nipil/arduino_spindle_encoder/perfboard-connection-card.odt

W : 5V DC U : GND S+Q : button O: enc GND M: enc 5V K: enc Z I: enc B G: enc A E: enc shield | J2: SHD-to-GND J1/08: ICP RST J1/07: ICP RX J1/06: ICP TX J1/05: ICP 5V J1/04: ICP GND H1/col_u: DBG H1/other: GND
