nipil/arduino_spindle_encoder/BOM.csv

ID | Name | Designator | Footprint | Quantity | Manufacturer Part | Manufacturer | Supplier | Supplier Part | Price
1 | KF301-5.0-2P | BTN,PWR | CONN-TH_P5.00_KF301-5.0-2P | 2 | KF301-5.0-2P | KEFA(科发) | LCSC | C474881 | 0.086
2 | 1u | C2 | CAP-D6.3×F2.5 | 1
3 | KF301-5.0-3P | ENCL,ENCR | CONN-TH_3P-P5.00_KF301-5.0-3P | 2 | KF301-5.0-3P | KEFA(科发) | LCSC | C474882 | 0.122
4 | HDR-F-2.54_1x2 | H1 | HDR-F-2.54_1X2 | 1 |  |  | LCSC | C49661 | 0.038
5 | HDR-M-2.54_1x5 | J1 | HDR-M-2.54_1X5 | 1 |  |  | LCSC | C358687 | 0.03
6 | HDR-M-2.54_1x2 | J2 | HDR-M-2.54_1X2 | 1 |  |  | LCSC | C124375 | 0.025
7 | 5641AS | LEDS | 5641AS | 1
8 | 330 | R1,R2,R3,R4 | R_AXIAL-0.5 | 4
9 | 3.3k | R5,R6,R7 | R_AXIAL-0.5 | 3
10 | 10k | R8,R9 | R_AXIAL-0.5 | 2
11 | ATMEGA328P-PU | U10 | DIP-28_L34.6-W7.3-P2.54-LS10.2-BL | 1 | ATMEGA328P-PU | MICROCHIP(美国微芯) | LCSC | C33901 | 2.203
