nipil/arduino_spindle_encoder/arduino_spindle_encoder.ino

/************************* optional stuff *************************/

// Using an encoder with a Z pin allows for a "fixed" homing
// This allows your position to be found again after a power loss
// #define USE_Z_RESET

// Use a digital pin to allow scoping interrupt duration
// #define USE_ISR_WAVEFORM

// Serial compile-time flag (use macros below)
// #define USE_SERIAL_PRINT

// Allow raw counter display
// #define USE_RAW_DISPLAY

// Display clock cycles of sensitive functions (requires USE_SERIAL_PRINT !)
// #define USE_TIMING

/************************** Configuration ******************************/

// For pins, you can use "native Arduino" pin numbers, or PIN_Pxy port defines from arduino.h,
// The latter allows clearer mapping, when using bare chipsets, like on the perfboards

// Display configuration (Arduino PINS)
#define CONFIG_PIN_OUT_SEGMENT_A 9
#define CONFIG_PIN_OUT_SEGMENT_B 13
#define CONFIG_PIN_OUT_SEGMENT_C 5
#define CONFIG_PIN_OUT_SEGMENT_D 7
#define CONFIG_PIN_OUT_SEGMENT_E 8
#define CONFIG_PIN_OUT_SEGMENT_F 10
#define CONFIG_PIN_OUT_SEGMENT_G A0
#define CONFIG_PIN_OUT_SEGMENT_DP 6
#define CONFIG_PIN_OUT_DIGIT_1 A2
#define CONFIG_PIN_OUT_DIGIT_2 A3
#define CONFIG_PIN_OUT_DIGIT_3 A4
#define CONFIG_PIN_OUT_DIGIT_4 A5
#define CONFIG_SEGMENT_ON_TIME_MICROS 10

// Encoder configuration (Arduino PINS)
#define CONFIG_ENCODER_PULSES_PER_REVOLUTION 1024  // number of rising edges per revolution !! PER signal !!
#define CONFIG_ENCODER_COUNTER_TYPE uint32_t       // choose uint16_t if your change rate is slow enough so you do not have overflows...
#define CONFIG_PIN_IN_QUAD_A 2
#define CONFIG_PIN_IN_QUAD_B 3
#if defined(USE_Z_RESET)
#define CONFIG_PIN_IN_QUAD_Z 4
#define CONFIG_PIN_IN_QUAD_Z_ACTIVE_STATE HIGH
#endif  // USE_Z_RESET

// UI configuration (Arduino PINS)
#define CONFIG_PIN_IN_BUTTON 12
#define CONFIG_PIN_IN_BUTTON_ACTIVE_STATE LOW
#define CONFIG_BUTTON_DEBOUNCE_MILLIS 100
#define CONFIG_BUTTON_LONG_PRESS_MILLIS 1000
#define CONFIG_UI_INTERVAL_MILLIS 500
#define CONFIG_DISPLAY_MODE_TEST_DURATION_MILLIS 1000

// Use led pin to scope for interrupt duration (Arduino PINS)
#if defined(USE_ISR_WAVEFORM)
#define CONFIG_PIN_OUT_ISR_WAVEFORM 11
#endif  // USE_ISR_WAVEFORM

// Define different macros for configurable digital pin manipulations
#define THROW_ERROR_IF_NOT_FAST  // MUST be declared before the include
#include <digitalWriteFast.h>

/************************* Macros *************************/

#if defined(USE_SERIAL_PRINT)
#define SERIAL_BEGIN(X) \
  do { Serial.begin(X); } while (0)
#define SERIAL_PRINT(X) \
  do { Serial.print(X); } while (0)
#define SERIAL_PRINTLN(X) \
  do { Serial.println(X); } while (0)
#define SERIAL_PRINT_2(X, Y) \
  do { Serial.print(X, Y); } while (0)
#define SERIAL_PRINTLN_2(X, Y) \
  do { Serial.println(X, Y); } while (0)
#else
#define SERIAL_BEGIN(X)
#define SERIAL_PRINT(X)
#define SERIAL_PRINTLN(X)
#define SERIAL_PRINT_2(X, Y)
#define SERIAL_PRINTLN_2(X, Y)
#endif

// Timer1 can be used to time things while running on target chip, but offline disassembly can too :
//    open disassembly file in the build folder C:\Users\xxxx\AppData\Local\arduino\sketches\YYYY\*.lst
//    look the address range you want to analyse
//    disassemble it again using avrdude,including the clock cycle count :
//      avrdude -p m8a  -c dryrun -U sketch.elf -T 'disasm -q flash 0x116 0x80'
//    and sum up the numbers in the second column !

#define PRINT_CLOCK_CYCLES(LABEL, X) \
  do { \
    TCCR1A = 0; \
    TCCR1B = 0; \
    TCNT1 = 0; \
    bitClear(TIFR, TOV1); \
    TCCR1B = 1; \
    X; \
    TCCR1B = 0; \
    bitClear(TIFR, TOV1); \
    SERIAL_PRINT(LABEL); \
    SERIAL_PRINT("="); \
    SERIAL_PRINT(TCNT1 - 1); \
    SERIAL_PRINT(" ovf="); \
    SERIAL_PRINTLN(bitRead(TIFR, TOV1)); \
  } while (0)

/************************** Library ******************************/

class Error {
public:
  typedef enum {
    ERROR_CODE_NONE = 0,
    ERROR_CODE_QUADRATURE,
  } Code;

  Error(const Code code, const uint32_t value = 0)
    : code(code), value(value) {}

  const Code code;
  const uint32_t value;
};

class Glyph {
public:
  typedef enum {
    // bit order is 0bPGFEDCBA
    DIGIT_ZERO = 0b00111111,
    DIGIT_ONE = 0b00000110,
    DIGIT_TWO = 0b01011011,
    DIGIT_THREE = 0b01001111,
    DIGIT_FOUR = 0b01100110,
    DIGIT_FIVE = 0b01101101,
    DIGIT_SIX = 0b01111101,
    DIGIT_SEVEN = 0b00000111,
    DIGIT_EIGHT = 0b01111111,
    DIGIT_NINE = 0b01101111,
    LETTER_I_LOWERCASE = 0b00010000,
    LETTER_N_LOWERCASE = 0b01010100,
    LETTER_T_LOWERCASE = 0b01111000,
    LETTER_E_UPPERCASE = 0b01111001,
    SYMBOL_SPACE = 0b00000000,
    SYMBOL_PERIOD = 0b10000000,
  } Bits;

  Glyph(const uint8_t bits)
    : bits(bits) {}

  void or_with(const Glyph& other) {
    bits |= other.bits;
  }

  uint8_t bits;
};

class GlyphLibrary {
public:
  typedef enum {
    DIGIT_ZERO = 0,
    DIGIT_ONE,
    DIGIT_TWO,
    DIGIT_THREE,
    DIGIT_FOUR,
    DIGIT_FIVE,
    DIGIT_SIX,
    DIGIT_SEVEN,
    DIGIT_EIGHT,
    DIGIT_NINE,
    LETTER_I_LOWERCASE,
    LETTER_N_LOWERCASE,
    LETTER_T_LOWERCASE,
    LETTER_E_UPPERCASE,
    SYMBOL_SPACE,
    SYMBOL_PERIOD,
    INDEX_MAX
  } GlyphIndex;

  static const Glyph GLYPHS[];

  static const Glyph& get_glyph(const uint8_t index) {
    if (index >= INDEX_MAX) {
      return GLYPHS[SYMBOL_SPACE];
    }
    return GLYPHS[index];
  }
};

const Glyph GlyphLibrary::GLYPHS[INDEX_MAX] = {
  Glyph(Glyph::Bits::DIGIT_ZERO),
  Glyph(Glyph::Bits::DIGIT_ONE),
  Glyph(Glyph::Bits::DIGIT_TWO),
  Glyph(Glyph::Bits::DIGIT_THREE),
  Glyph(Glyph::Bits::DIGIT_FOUR),
  Glyph(Glyph::Bits::DIGIT_FIVE),
  Glyph(Glyph::Bits::DIGIT_SIX),
  Glyph(Glyph::Bits::DIGIT_SEVEN),
  Glyph(Glyph::Bits::DIGIT_EIGHT),
  Glyph(Glyph::Bits::DIGIT_NINE),
  Glyph(Glyph::Bits::LETTER_I_LOWERCASE),
  Glyph(Glyph::Bits::LETTER_N_LOWERCASE),
  Glyph(Glyph::Bits::LETTER_T_LOWERCASE),
  Glyph(Glyph::Bits::LETTER_E_UPPERCASE),
  Glyph(Glyph::Bits::SYMBOL_SPACE),
  Glyph(Glyph::Bits::SYMBOL_PERIOD),
};

typedef enum {
  COMMON_CATHODE = LOW,
  COMMON_ANODE = HIGH, /* TODO: untested */
} DisplayType;

class SevenSegmentPins {
public:
  typedef enum {
    SEGMENT_A = 0,
    SEGMENT_B,
    SEGMENT_C,
    SEGMENT_D,
    SEGMENT_E,
    SEGMENT_F,
    SEGMENT_G,
    SEGMENT_DP,
    SEGMENT_MAX
  } SegmentPinIndex;

  SevenSegmentPins(
    const DisplayType display_type,
    const uint16_t time_on_micros)
    : display_type(display_type),
      time_on_micros(time_on_micros) {}

  void setup() const {

#define LOCAL_MACRO_SETUP_SEGMENT_FAST(pin_number) \
  do { \
    pinModeFast(pin_number, OUTPUT); \
    digitalWriteFast(pin_number, display_type); \
  } while (0)

    LOCAL_MACRO_SETUP_SEGMENT_FAST(CONFIG_PIN_OUT_SEGMENT_A);
    LOCAL_MACRO_SETUP_SEGMENT_FAST(CONFIG_PIN_OUT_SEGMENT_B);
    LOCAL_MACRO_SETUP_SEGMENT_FAST(CONFIG_PIN_OUT_SEGMENT_C);
    LOCAL_MACRO_SETUP_SEGMENT_FAST(CONFIG_PIN_OUT_SEGMENT_D);
    LOCAL_MACRO_SETUP_SEGMENT_FAST(CONFIG_PIN_OUT_SEGMENT_E);
    LOCAL_MACRO_SETUP_SEGMENT_FAST(CONFIG_PIN_OUT_SEGMENT_F);
    LOCAL_MACRO_SETUP_SEGMENT_FAST(CONFIG_PIN_OUT_SEGMENT_G);
    LOCAL_MACRO_SETUP_SEGMENT_FAST(CONFIG_PIN_OUT_SEGMENT_DP);

#undef LOCAL_MACRO_SETUP_SEGMENT_FAST /* no further use */
  }

  void render_glyph(const Glyph& glyph) const {
    uint8_t glyph_bits = glyph.bits;
    bool segment_is_on;

#define LOCAL_MACRO_RENDER_SEGMENT_FAST(pin_number) \
  do { \
    segment_is_on = glyph_bits & 1; \
    digitalWriteFast(pin_number, !display_type ^ !segment_is_on); /* enable segment pin (if needed) */ \
    delayMicroseconds(time_on_micros); \
    digitalWriteFast(pin_number, display_type); /* disable segment pin (always) */ \
    glyph_bits >>= 1; \
  } while (0)

    LOCAL_MACRO_RENDER_SEGMENT_FAST(CONFIG_PIN_OUT_SEGMENT_A);
    LOCAL_MACRO_RENDER_SEGMENT_FAST(CONFIG_PIN_OUT_SEGMENT_B);
    LOCAL_MACRO_RENDER_SEGMENT_FAST(CONFIG_PIN_OUT_SEGMENT_C);
    LOCAL_MACRO_RENDER_SEGMENT_FAST(CONFIG_PIN_OUT_SEGMENT_D);
    LOCAL_MACRO_RENDER_SEGMENT_FAST(CONFIG_PIN_OUT_SEGMENT_E);
    LOCAL_MACRO_RENDER_SEGMENT_FAST(CONFIG_PIN_OUT_SEGMENT_F);
    LOCAL_MACRO_RENDER_SEGMENT_FAST(CONFIG_PIN_OUT_SEGMENT_G);
    LOCAL_MACRO_RENDER_SEGMENT_FAST(CONFIG_PIN_OUT_SEGMENT_DP);

#undef LOCAL_MACRO_RENDER_SEGMENT_FAST /* no further use */
  }

public:
  const DisplayType display_type;

private:
  const uint16_t time_on_micros;
};

typedef enum {
  DISPLAY_1 = 0,
  DISPLAY_2,
  DISPLAY_3,
  DISPLAY_4,
  DISPLAY_MAX
} DisplayIndex;

class Glyphs {
public:
  static const Glyphs INIT;
  static const Glyphs TEST;
  static const Glyphs EMPTY;

  Glyphs(const Glyph& glyph1, const Glyph& glyph2, const Glyph& glyph3, const Glyph& glyph4)
    : glyphs{ glyph1, glyph2, glyph3, glyph4 } {}

  Glyph& get_glyph(const DisplayIndex index) {
    if (index >= DISPLAY_MAX) {
      return glyphs[0];  // protection
    }
    return glyphs[index];
  }

  const Glyph& get_glyph_ref(const DisplayIndex index) const {
    // return get_glyph(index);  // does not compile due to const discard
    if (index >= DISPLAY_MAX) {
      return glyphs[0];  // protection
    }
    return glyphs[index];
  }

  static Glyphs build_uint16(uint16_t value, uint8_t min_digit) {
    GlyphLibrary::GlyphIndex digits[DISPLAY_MAX] = {
      GlyphLibrary::SYMBOL_SPACE,
      GlyphLibrary::SYMBOL_SPACE,
      GlyphLibrary::SYMBOL_SPACE,
      GlyphLibrary::SYMBOL_SPACE
    };
    for (uint8_t i = 0; i < DISPLAY_MAX; i++) {
      if (value == 0 && i >= min_digit) {
        break;
      }
      uint8_t units = value % 10;
      digits[i] = (GlyphLibrary::GlyphIndex)units;
      value = (value - units) / 10;
    }
    return Glyphs(  // rendering de gauche à droite
      GlyphLibrary::get_glyph(digits[3]),
      GlyphLibrary::get_glyph(digits[2]),
      GlyphLibrary::get_glyph(digits[1]),
      GlyphLibrary::get_glyph(digits[0]));
  }

private:
  static const Glyphs build_test() {
    Glyph full = GlyphLibrary::get_glyph(GlyphLibrary::DIGIT_EIGHT);
    full.or_with(GlyphLibrary::get_glyph(GlyphLibrary::SYMBOL_PERIOD));
    return Glyphs(full, full, full, full);
  }

  static const Glyphs build_init() {
    Glyph i = GlyphLibrary::get_glyph(GlyphLibrary::LETTER_I_LOWERCASE);
    return Glyphs(
      i,
      GlyphLibrary::get_glyph(GlyphLibrary::LETTER_N_LOWERCASE),
      i,
      GlyphLibrary::get_glyph(GlyphLibrary::LETTER_T_LOWERCASE));
  }

  static const Glyphs build_empty() {
    Glyph empty = GlyphLibrary::get_glyph(GlyphLibrary::SYMBOL_SPACE);
    return Glyphs(empty, empty, empty, empty);
  }

  Glyph glyphs[DISPLAY_MAX];
};

const Glyphs Glyphs::INIT = Glyphs::build_init();
const Glyphs Glyphs::TEST = Glyphs::build_test();
const Glyphs Glyphs::EMPTY = Glyphs::build_empty();

class FourDigitDisplay {
public:
  FourDigitDisplay(const SevenSegmentPins& segment_pins)
    : segment_pins(segment_pins) {}

  void setup() const {

#define LOCAL_MACRO_SETUP_DIGIT_FAST(pin_number) \
  do { \
    pinModeFast(pin_number, OUTPUT); \
    digitalWriteFast(pin_number, !segment_pins.display_type); \
  } while (0)

    LOCAL_MACRO_SETUP_DIGIT_FAST(CONFIG_PIN_OUT_DIGIT_1);
    LOCAL_MACRO_SETUP_DIGIT_FAST(CONFIG_PIN_OUT_DIGIT_2);
    LOCAL_MACRO_SETUP_DIGIT_FAST(CONFIG_PIN_OUT_DIGIT_3);
    LOCAL_MACRO_SETUP_DIGIT_FAST(CONFIG_PIN_OUT_DIGIT_4);

#undef LOCAL_MACRO_SETUP_DIGIT_FAST /* no further use */
  }

  void render_glyphs(const Glyphs& glyphs) const {

#define LOCAL_MACRO_RENDER_DIGIT_FAST(pin_number, display_number) \
  do { \
    digitalWriteFast(pin_number, segment_pins.display_type); /* enable digit pin */ \
    segment_pins.render_glyph(glyphs.get_glyph_ref(display_number)); \
    digitalWriteFast(pin_number, !segment_pins.display_type); /* disable digit pin */ \
  } while (0)

    LOCAL_MACRO_RENDER_DIGIT_FAST(CONFIG_PIN_OUT_DIGIT_1, DISPLAY_1);
    LOCAL_MACRO_RENDER_DIGIT_FAST(CONFIG_PIN_OUT_DIGIT_2, DISPLAY_2);
    LOCAL_MACRO_RENDER_DIGIT_FAST(CONFIG_PIN_OUT_DIGIT_3, DISPLAY_3);
    LOCAL_MACRO_RENDER_DIGIT_FAST(CONFIG_PIN_OUT_DIGIT_4, DISPLAY_4);

#undef LOCAL_MACRO_RENDER_DIGIT_FAST /* no further use */
  }

private:
  const SevenSegmentPins& segment_pins;
};


class Encoder {
public:
  typedef void (*IsrFunc)(void);

  Encoder(
    const uint16_t pulse_per_revolution
#if defined(USE_Z_RESET)
    ,
    const uint8_t pin_z_active_state
#endif  // USE_Z_RESET
    )
    : pulse_per_revolution(pulse_per_revolution),
      // Encoder count of A/B signal *changes* in a single turn
      // = max raw value before over/under flowing
      raw_value_range(pulse_per_revolution << 2)
#if defined(USE_Z_RESET)
      ,
      pin_z_active_state(pin_z_active_state)
#endif  // USE_Z_RESET
  {
  }

  void setup() const {
    pinModeFast(CONFIG_PIN_IN_QUAD_A, INPUT);
    pinModeFast(CONFIG_PIN_IN_QUAD_B, INPUT);
#if defined(USE_Z_RESET)
    pinModeFast(CONFIG_PIN_IN_QUAD_Z, INPUT);
#endif  // USE_Z_RESET
  }

  inline uint8_t get_pin_a() const __attribute__((always_inline)) {
    // 4 clock cycles
    return digitalReadFast(CONFIG_PIN_IN_QUAD_A);
  }

  inline uint8_t get_pin_b() const __attribute__((always_inline)) {
    // 4 clock cycles
    return digitalReadFast(CONFIG_PIN_IN_QUAD_B);
  }

#if defined(USE_Z_RESET)
  inline bool reset_detected() const __attribute__((always_inline)) {
    // 7 clock cycles
    return digitalReadFast(CONFIG_PIN_IN_QUAD_Z) == pin_z_active_state;
  }
#endif  // USE_Z_RESET

  void uninstall_all_isr() {
    detachInterrupt(digitalPinToInterrupt(CONFIG_PIN_IN_QUAD_A));
    detachInterrupt(digitalPinToInterrupt(CONFIG_PIN_IN_QUAD_B));
  }

  void install_isr_change_a_b(IsrFunc isr) {
    attachInterrupt(digitalPinToInterrupt(CONFIG_PIN_IN_QUAD_A), isr, CHANGE);
    attachInterrupt(digitalPinToInterrupt(CONFIG_PIN_IN_QUAD_B), isr, CHANGE);
  }

  void install_isr_rising_a(IsrFunc isr) {
    attachInterrupt(digitalPinToInterrupt(CONFIG_PIN_IN_QUAD_A), isr, RISING);
  }

public:
  const uint16_t pulse_per_revolution;
  const uint16_t raw_value_range;

private:
#if defined(USE_Z_RESET)
  const uint8_t pin_z_active_state;
#endif  // USE_Z_RESET
};

class Quadrature {
public:
  Quadrature(const Encoder& encoder)
    : encoder(encoder), state(0), counter(0), relative_zero(0), error_flag(0) {
#if defined(USE_Z_RESET)
    require_homing();
#endif  // USE_Z_RESET
  }

  inline void update_state_from_inputs() __attribute__((always_inline)) {
    // see time_sensitive_functions() for performance
    state = ((state & 0b0011) << 2) | ((encoder.get_pin_b() & 1) << 1) | (encoder.get_pin_a() & 1);
  }

  inline void update_counter_from_quadrature() __attribute__((always_inline)) {
    // see time_sensitive_functions() for performance
    const uint8_t result = LOOKUP[state];
    const int8_t delta = (int8_t)result & 0b00000111;
    counter += delta - 1;
    if (result > CW) {
      const uint8_t error = (result >> 3) & 0b00001111;
      error_flag |= error;
    }
#if defined(USE_Z_RESET)
    if (encoder.reset_detected()) {
      counter = 0;
      homing_canary = true;
    }
#endif  // USE_Z_RESET
  }

  void initialize_state() {
    // build a valid state from two reads
    update_state_from_inputs();
    update_state_from_inputs();
  }

  void setup() {
    initialize_state();
  }

  void clear_counter() {
    counter = 0;
  }

  inline void increment_counter() __attribute__((always_inline)) {
    // see time_sensitive_functions() for performance
    counter++;
  }

  uint32_t get_counter() const {
    return counter - relative_zero;
  }

  void set_relative_zero() {
    relative_zero = counter;
  }

  uint8_t get_error() const {
    return error_flag;
  }

  void clear_error() {
    initialize_state();
    error_flag = 0;
  }

#if defined(USE_Z_RESET)
  void require_homing() {
    homing_canary = false;
  }

  bool is_homed() const {
    return homing_canary;
  }
#endif  // USE_Z_RESET

  // 1 state bit for dual signal, and a before and after => 4 bits required
  static const uint8_t LOOKUP_SIZE = (1 << 4);

  // LookupResult has an integer values of "0bFEEEEVVV" where
  // - F is error flag
  // - E is error code (0-16)
  // - V is "counter_increment+1" on 3 bits
  typedef enum {
    CCW = 0,                 // -1 without error
    NOOP = 1,                // 0 without error
    CW = 2,                  // +1 without error
    INVALID_3 = 0b10011000,  // 0 with error and state was 0b0011 = 3
    INVALID_6 = 0b10110000,  // 0 with error and state was 0b0110 = 6
    INVALID_9 = 0b11001000,  // 0 with error and state was 0b1001 = 9
    INVALID_C = 0b11100000,  // 0 with error and state was 0b1100 = 12
  } LookupResult;

  static const uint8_t LOOKUP[];

private:
  const Encoder& encoder;
  volatile uint8_t state;
  volatile CONFIG_ENCODER_COUNTER_TYPE counter;
  CONFIG_ENCODER_COUNTER_TYPE relative_zero;
  volatile uint8_t error_flag;
#if defined(USE_Z_RESET)
  volatile bool homing_canary;
#endif  // USE_Z_RESET
};

const uint8_t Quadrature::LOOKUP[LOOKUP_SIZE] = {
  /* i old new        */
  /*    ba BA         */
  /* 0  00 00 same    */ NOOP,
  /* 1  00 01 cw 1    */ CW,
  /* 2  00 10 ccw 1   */ CCW,
  /* 3  00 11 invalid */ INVALID_3,
  /* 4  01 00 ccw 4   */ CCW,
  /* 5  01 01 same    */ NOOP,
  /* 6  01 10 invalid */ INVALID_6,
  /* 7  01 11 cw 2 Z  */ CW,
  /* 8  10 00 cw 4    */ CW,
  /* 9  10 01 invalid */ INVALID_9,
  /* A  10 10 same    */ NOOP,
  /* B  10 11 ccw 2   */ CCW,
  /* C  11 00 invalid */ INVALID_C,
  /* D  11 01 ccw 3 Z */ CCW,
  /* E  11 10 cw 3 Z  */ CW,
  /* F  11 11 same    */ NOOP
};

#if defined(USE_ISR_WAVEFORM)
class IsrMonitor {
public:
  void setup() const {
    pinModeFast(CONFIG_PIN_OUT_ISR_WAVEFORM, OUTPUT);
    digitalWriteFast(CONFIG_PIN_OUT_ISR_WAVEFORM, LOW);
  }

  inline void start() const __attribute__((always_inline)) {
    digitalWriteFast(CONFIG_PIN_OUT_ISR_WAVEFORM, HIGH);
  }

  inline void stop() const __attribute__((always_inline)) {
    digitalWriteFast(CONFIG_PIN_OUT_ISR_WAVEFORM, LOW);
  }
};
#endif  // USE_ISR_WAVEFORM

class DebouncedButton {
public:
  DebouncedButton(
    const uint8_t active_state,
    const uint32_t debounce_millis,
    const uint32_t long_press_millis)
    : active_state(active_state),
      debounce_millis(debounce_millis),
      long_press_millis(long_press_millis),
      last_value(0),
      stored_state(0),
      last_change_millis(0L),
      long_press_has_been_triggered(false) {}

  void setup() {
    pinModeFast(CONFIG_PIN_IN_BUTTON, INPUT);
    last_value = stored_state = digitalReadFast(CONFIG_PIN_IN_BUTTON);
    last_change_millis = millis();
  }

  bool update() {
    // read and debounce
    uint8_t current_state = digitalReadFast(CONFIG_PIN_IN_BUTTON);
    uint32_t current_millis = millis();
    if (current_state != stored_state) {
      stored_state = current_state;
      last_change_millis = current_millis;
    }
    if (stored_state != last_value && current_millis - last_change_millis > debounce_millis) {
      last_value = stored_state;  // change has persisted for long enough
      if (long_press_has_been_triggered && stored_state != active_state) {
        return false;  // after a long press, do NOT notify of button RELEASE
      }
      long_press_has_been_triggered = false;  // clear the long press event masking lag
      return true;                            // notify on value change
    }
    return false;
  }

  bool detect_long_press() {
    const uint32_t current_millis = millis();
    const uint32_t duration_millis = current_millis - last_change_millis;
    // 1) triggers on continuous press, so do not trigger while released
    // 2) do not trigger before a long press could have happened
    // 3) do not trigger if the long press already happened
    if (stored_state != active_state || duration_millis < long_press_millis || long_press_has_been_triggered) {
      return false;
    }
    // Mark it as happened so no more event
    long_press_has_been_triggered = true;
    return true;
  }

  bool is_active() const {
    return stored_state == active_state;
  }

private:
  const uint8_t active_state;
  const uint32_t debounce_millis;
  const uint32_t long_press_millis;
  uint8_t last_value;
  uint8_t stored_state;
  uint32_t last_change_millis;
  bool long_press_has_been_triggered;
};

/************************* Global variables (required for interrupts) *************************/

Encoder global_encoder(
  CONFIG_ENCODER_PULSES_PER_REVOLUTION
#if defined(USE_Z_RESET)
  ,
  CONFIG_PIN_IN_QUAD_Z_ACTIVE_STATE
#endif  // USE_Z_RESET
);

Quadrature global_quadrature(global_encoder);

/************************* Interrup service routines (need global variables) *************************/

#if defined(USE_ISR_WAVEFORM)
IsrMonitor global_isr_monitor;
#endif  // USE_ISR_WAVEFORM

void isr_position() {

#if defined(USE_ISR_WAVEFORM)
  global_isr_monitor.start();
#endif  // USE_ISR_WAVEFORM

  global_quadrature.update_state_from_inputs();
  global_quadrature.update_counter_from_quadrature();

#if defined(USE_ISR_WAVEFORM)
  global_isr_monitor.stop();
#endif  // USE_ISR_WAVEFORM
}

void isr_speed() {
#if defined(USE_ISR_WAVEFORM)
  global_isr_monitor.start();
#endif  // USE_ISR_WAVEFORM

  global_quadrature.increment_counter();

#if defined(USE_ISR_WAVEFORM)
  global_isr_monitor.stop();
#endif  // USE_ISR_WAVEFORM
}

/************************* Application code (needs ISR routines) *************************/

class RpmCalculator {
public:
  RpmCalculator(const Encoder& encoder, const Quadrature& quadrature)
    : encoder(encoder), quadrature(quadrature) {
    reset();
  }

  void reset() {
    last_rpm_computation_millis = millis();
    last_counter = quadrature.get_counter();
    rpm_value = 0;
  }

  void update() {
    uint32_t current_millis = millis();
    uint32_t interval_millis = current_millis - last_rpm_computation_millis;
    // only update every once in a while
    if (interval_millis > CONFIG_UI_INTERVAL_MILLIS) {
      last_rpm_computation_millis = current_millis;
      uint32_t current_counter = quadrature.get_counter();
      uint16_t counter_diff = current_counter - last_counter;
      last_counter = current_counter;
      // convert counter difference to "per minute" and switch to "millis"
      // divide by elasped time, keep only full turns, clip to display, and store
      uint32_t result = 60000 * counter_diff;
      result /= interval_millis * encoder.pulse_per_revolution;
      if (result > 9999) {
        result = 9999;
      }
      rpm_value = result;
    }
  }

  uint16_t get_rpm() const {
    return rpm_value;
  }

private:
  const Encoder& encoder;
  const Quadrature& quadrature;
  uint32_t last_rpm_computation_millis;
  uint32_t last_counter;
  uint16_t rpm_value;
};

class Application {
public:
  typedef enum {
    TEST = 0,
    RPM,
    DEGREES,
#if defined(USE_RAW_DISPLAY)
    RAW,
#endif  // USE_RAW_DISPLAY
    ERROR,
#if defined(USE_Z_RESET)
    INIT,
#endif  // USE_Z_RESET
  } Mode;

  Application(
    Encoder& encoder,
    Quadrature& quadrature,
    FourDigitDisplay& display,
    DebouncedButton& button)
    : encoder(encoder),
      quadrature(quadrature),
      display(display),
      button(button),
      mode(TEST),
      self_test_done(false),
      rpm_calculator(encoder, quadrature) {}

  void setup() {
    set_mode_test();
  }

  void request_mode(Mode requested_mode) {
    if (requested_mode == mode) {
      return;
    }
    switch (requested_mode) {
      case TEST:
        set_mode_test();
        break;
      case RPM:
        set_mode_rpm();
        break;
      case DEGREES:
        set_mode_degrees();
        break;
#if defined(USE_RAW_DISPLAY)
      case RAW:
        set_mode_raw();
        break;
#endif  // USE_RAW_DISPLAY
      case ERROR:
        set_mode_error();
        break;
#if defined(USE_Z_RESET)
      case INIT:
        set_mode_init();
        break;
#endif  // USE_Z_RESET
    }
  }

  void loop_test() {
    if (!self_test_done && millis() > CONFIG_DISPLAY_MODE_TEST_DURATION_MILLIS) {
      self_test_done = true;
      request_mode(RPM);
    }
    display.render_glyphs(Glyphs::TEST);
  }

  void loop_rpm() {
    rpm_calculator.update();
    Glyphs glyphs = Glyphs::build_uint16(rpm_calculator.get_rpm(), 1);
    display.render_glyphs(glyphs);
  }

  void loop_degrees() {
    uint32_t counter = quadrature.get_counter() % encoder.raw_value_range;
    counter = 360 * 10 * counter / encoder.raw_value_range;
    Glyphs glyphs = Glyphs::build_uint16(counter, 2);
    const Glyph& period = GlyphLibrary::get_glyph(GlyphLibrary::SYMBOL_PERIOD);
    glyphs.get_glyph(DisplayIndex::DISPLAY_3).or_with(period);
    display.render_glyphs(glyphs);
  }

#if defined(USE_RAW_DISPLAY)
  void loop_raw() const {
    uint32_t counter = quadrature.get_counter() % encoder.raw_value_range;
    Glyphs glyphs = Glyphs::build_uint16(counter, 1);
    // overlay period on all digits to show we are in RAW mode
    const Glyph& period = GlyphLibrary::get_glyph(GlyphLibrary::SYMBOL_PERIOD);
    for (int i = 0; i < DISPLAY_MAX; i++) {
      Glyph& glyph = glyphs.get_glyph((DisplayIndex)i);
      glyph.or_with(period);
    }
    display.render_glyphs(glyphs);
  }
#endif  // USE_RAW_DISPLAY

  void loop_error(uint8_t error_code) {
    Glyphs glyphs = Glyphs::build_uint16(error_code, 3);
    const Glyph& letter_e = GlyphLibrary::get_glyph(GlyphLibrary::LETTER_E_UPPERCASE);
    glyphs.get_glyph(DisplayIndex::DISPLAY_1).or_with(letter_e);
    display.render_glyphs(glyphs);
  }

#if defined(USE_Z_RESET)
  void loop_init() {
    if (quadrature.is_homed()) {
      request_mode(DEGREES);
    }
    display.render_glyphs(Glyphs::INIT);
  }
#endif  // USE_Z_RESET

  void loop() {
    bool button_short_press = button.update() && !button.is_active();  // order is important
    bool button_long_press = button.detect_long_press();               // must be called after update

    // error management by priority
    uint8_t error = quadrature.get_error();
    if (error) {
      request_mode(ERROR);
    }

    switch (mode) {
      case TEST:
        loop_test();
        break;
      case RPM:
        loop_rpm();
        if (button_short_press) {
#if defined(USE_Z_RESET)
          request_mode(INIT);
#else
          request_mode(DEGREES);
#endif  // USE_Z_RESET
        }
        break;
      case DEGREES:
        if (button_long_press) {
          SERIAL_PRINTLN("Setting new zero");
          quadrature.set_relative_zero();
        }
        loop_degrees();
        if (button_short_press) {
#if defined(USE_RAW_DISPLAY)
          request_mode(RAW);
#else
          request_mode(RPM);
#endif  // USE_RAW_DISPLAY
        }
        break;
#if defined(USE_RAW_DISPLAY)
      case RAW:
        if (button_long_press) {
          SERIAL_PRINTLN("Setting new zero");
          quadrature.set_relative_zero();
        }
        loop_raw();
        if (button_short_press) {
          request_mode(RPM);
        }
        break;
#endif  // USE_RAW_DISPLAY
      case ERROR:
        loop_error(error);
        if (button_short_press) {
          quadrature.clear_error();
          request_mode(TEST);
        }
        break;
#if defined(USE_Z_RESET)
      case INIT:
        loop_init();
        if (button_short_press) {
#if defined(USE_RAW_DISPLAY)
          request_mode(RAW);
#else
          request_mode(RPM);
#endif  // USE_RAW_DISPLAY
        }
        break;
#endif  // USE_Z_RESET
    }
  }

private:
  void set_mode_test() {
    encoder.uninstall_all_isr();
    mode = TEST;
    self_test_done = false;
    SERIAL_PRINTLN("Mode TEST");
    quadrature.clear_counter();
  }

  void set_mode_rpm() {
    encoder.uninstall_all_isr();
    mode = RPM;
    SERIAL_PRINTLN("Mode RPM");
    quadrature.clear_counter();
    rpm_calculator.reset();
    encoder.install_isr_rising_a(isr_speed);
  }

  void set_mode_degrees() {
    encoder.uninstall_all_isr();
    mode = DEGREES;
    SERIAL_PRINTLN("Mode DEGREES");
    quadrature.clear_counter();
    encoder.install_isr_change_a_b(isr_position);
  }

#if defined(USE_RAW_DISPLAY)
  void set_mode_raw() {
    encoder.uninstall_all_isr();
    mode = RAW;
    SERIAL_PRINTLN("Mode RAW");
    quadrature.clear_counter();
    encoder.install_isr_change_a_b(isr_position);
  }
#endif  // USE_RAW_DISPLAY

  void set_mode_error() {
    encoder.uninstall_all_isr();
    mode = ERROR;
    SERIAL_PRINTLN("Mode ERROR");
  }

#if defined(USE_Z_RESET)
  void set_mode_init() {
    encoder.uninstall_all_isr();
    mode = INIT;
    SERIAL_PRINTLN("Mode INIT");
    quadrature.clear_counter();
    quadrature.require_homing();
    encoder.install_isr_change_a_b(isr_position);
  }
#endif  // USE_Z_RESET

  Encoder& encoder;
  Quadrature& quadrature;
  FourDigitDisplay& display;
  DebouncedButton& button;
  Mode mode;
  bool self_test_done;
  RpmCalculator rpm_calculator;
};

/************************* Other global variables *************************/

SevenSegmentPins global_segment_pins(
  DisplayType::COMMON_CATHODE,
  CONFIG_SEGMENT_ON_TIME_MICROS);

FourDigitDisplay global_display(
  global_segment_pins);

DebouncedButton global_button(
  CONFIG_PIN_IN_BUTTON_ACTIVE_STATE,
  CONFIG_BUTTON_DEBOUNCE_MILLIS,
  CONFIG_BUTTON_LONG_PRESS_MILLIS);

/************************* Arduino framework *************************/

Application global_application(
  global_encoder,
  global_quadrature,
  global_display,
  global_button);

void setup() {
  SERIAL_BEGIN(9600);
  SERIAL_PRINTLN("Starting...");
#if defined(USE_ISR_WAVEFORM)
  global_isr_monitor.setup();
#endif  // USE_ISR_WAVEFORM
  global_encoder.setup();
  global_quadrature.setup();
  global_segment_pins.setup();
  global_display.setup();
  global_button.setup();
  global_application.setup();
}

#if defined(USE_TIMING)
void time_sensitive_functions() {
  PRINT_CLOCK_CYCLES("ck_enc_ab", global_encoder.get_pin_a());
  PRINT_CLOCK_CYCLES("ck_enc_rst", global_encoder.reset_detected());
  PRINT_CLOCK_CYCLES("ck_quad_inc", global_quadrature.increment_counter());
  PRINT_CLOCK_CYCLES("ck_quad_in", global_quadrature.update_state_from_inputs());
  PRINT_CLOCK_CYCLES("ck_quad_up", global_quadrature.update_counter_from_quadrature());

  // with a 32-bit quadrature counter
  // ck_enc_ab=1 ovf=1
  // ck_enc_rst=1 ovf=1
  // ck_quad_inc=20 ovf=1
  // ck_quad_in=24 ovf=1
  // ck_quad_up=53 ovf=1
  // loops=1472 (without any interrupt activity)

  // with a 16-bit quadrature counter
  // ck_enc_ab=1 ovf=1
  // ck_enc_rst=1 ovf=1
  // ck_quad_inc=10 ovf=1
  // ck_quad_in=24 ovf=1
  // ck_quad_up=40 ovf=1
  // loops=1473 (without any interrupt activity)

  // isr waveform duration
  // rpm mode = 1.74us ~ (quad_inc) * 125ns
  // deg/raw mode = 7.71us ~ (quad_in + quad_up) * 125ns
}
#endif  // USE_TIMING

void loop() {
  global_application.loop();

#if defined(USE_TIMING)
  static uint32_t last = 0;
  if (millis() - last > 1000) {
    last = millis();
    time_sensitive_functions();
  }
#endif  // USE_TIMING
}
