nipil/arduino_spindle_encoder/(commit log)

2025-09-14 display raw position once homing is done
2025-09-14 Angular position, POST and error display
    [arduino_spindle_encoder.ino]
2025-09-14 Button to switch more, ack errors, and reset position
    [arduino_spindle_encoder.ino]
2025-09-14 allow switching to relative coordinates
2025-09-14 optional encoder reset pin : not safe against power loss during work
2025-09-14 FIX: underflow bug without Z pin + ENH: simplify init with Z pin
    [arduino_spindle_encoder.ino]
2025-09-15 really FIX: underflow bug w/o Z pin + really ENH: simplify init
    [arduino_spindle_encoder.ino]
2025-09-15 FIX: graceful handling of initial quadrature errors
    [arduino_spindle_encoder.ino]
2025-09-15 Better project description + optional ISR pin-tracing
2025-09-15 Breadboard prototype
2025-09-16 Add Atmega328p schematic
    [BOM.csv]
2025-09-16 Add first try at laying it out on a perfboard
    [BOM.csv]
2025-09-19 Update MCU pin for display G, to keep XTAL pins free/customizable
2025-09-24 Add perfboard advised soldering order
2025-09-24 Perfboard soldering hints, and connection guide
2025-09-24 Update Arduino UNO pin and schematic to match Atmega from perfboard
2025-09-24 Add "print connection card" for perfboard
2025-09-26 FIX: missing output setup for debug pin
    [arduino_spindle_encoder.ino]
2025-09-27 Use fast pin functions for hot code in interrupt handlers
2025-09-27 Optimize hot loop speed, reworked quad lookup, and do timing
    [arduino_spindle_encoder.ino]
2025-09-27 Fix oversized type for relative counter offset
    [arduino_spindle_encoder.ino]
2025-09-27 Enhance clearing quadrature error by getting a fresh state
    [arduino_spindle_encoder.ino]
2025-09-27 Fix quadrature error code (remove error flag from value)
    [arduino_spindle_encoder.ino]
2025-09-27 Fix compilation error when USE_Z_RESET is disabled
    [arduino_spindle_encoder.ino]
